sukanta0011/BabyMonitor/screenshots/babymonitor_v1.gif

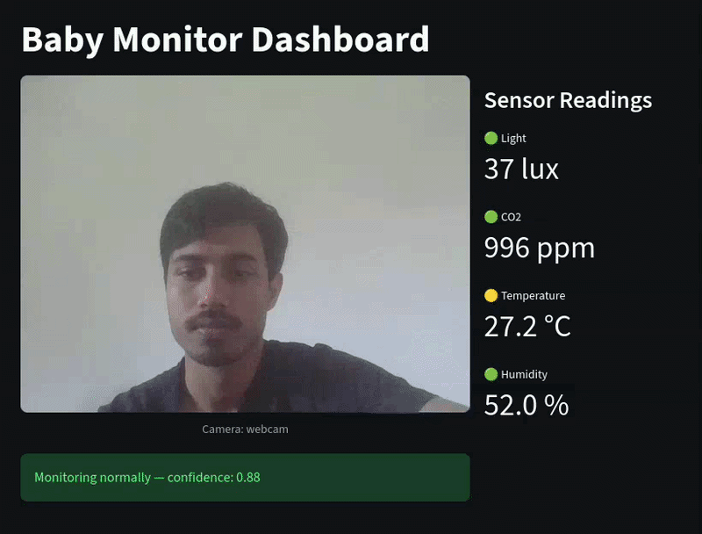
screenshots/babymonitor_v1.gif
