sukanta0011/BabyMonitor/esp32_codes/display/main/main.ino

#include <algorithm>
#include <HTTPClient.h>
#include <TJpg_Decoder.h>
#include <Arduino_GFX_Library.h>
#include <ArduinoJson.h>
#include "utils.hpp"
#include "ringBuffer.hpp"


// // Pin Definitions for ESP32-S3-CAM
// #define TFT_MOSI 17
// #define TFT_SCLK 18
// #define TFT_CS    3
// #define TFT_DC   15
// #define TFT_RST  16

// Pin Definitions for ESP32-S3-dev-kit
#define TFT_MOSI 11
#define TFT_SCLK 12
#define TFT_CS   10
#define TFT_DC   15
#define TFT_RST  16

// Interrupt Button
#define BUTTON_PIN 9

// Colour
#define COLOR_TEMP   0xFBE0  // orange
#define COLOR_HUM    0x07FF  // cyan
#define COLOR_CO2    0xF800  // red
#define COLOR_LUX    0xFFE0  // yellow
#define COLOR_BG     0x0000  // black
#define COLOR_LABEL  0x8410  // grey
#define COLOR_WHT    0xFFFF  // grey


const uint32_t                      buffer_size = 102400;
uint32_t                            start = 0, end = 0;
std::string                         marker = "--frame\r\n";
HTTPClient                          cam1Http, cam2Http, sensorHttp;
WiFiClient                          *cam1Stream, *cam2Stream;
// HTTPClient                          *activeHttp;
WiFiClient                          *stream;
int                                 httpCode;
RingBuffer<uint8_t, buffer_size>    buffer;
uint8_t                             *buffer_cpy = (uint8_t*)ps_malloc(buffer_size);
Arduino_DataBus                     *bus = new Arduino_ESP32SPI(
    TFT_DC, TFT_CS, TFT_SCLK, TFT_MOSI, GFX_NOT_DEFINED);
Arduino_GFX                         *gfx = new Arduino_ILI9488_18bit(
    bus, TFT_RST, 3 /* rotation */, false /* IPS */);
TaskHandle_t    readTaskHandle, extractAndDisplayTask, sensorTaskHandler;


float                               lux_val = 0, temp_val = 0, humidity_val = 0;
int                                 co2_val = 0;
bool                                sensors_valid = false;
SemaphoreHandle_t                   sensor_mutex;
volatile uint32_t                   last_interrupt_time = 0;
char outdoor_city[24] = "";
float outdoor_temp = 0, outdoor_humidity = 0;
bool outdoor_valid = false;

uint16_t src_img_w, src_img_h;
float scale_factor = 1.0;

enum     DisplayMode { SENSORS, CAM1, CAM2};
volatile DisplayMode requested_mode = CAM2;
volatile DisplayMode current_mode = CAM2;

struct  task_status 
{
    bool    read_task = false;
    bool    display_task = false;
    bool    sensor_task = false;
    bool    cam1_stream_status = false;
    bool    cam2_stream_status = false;
    bool    sensor_stream_status = false;
};


task_status taskStatus;

void    IRAM_ATTR button_isr()
{
    uint32_t    now = millis();
    if (now - last_interrupt_time > 50)
    {
        requested_mode = (DisplayMode)((requested_mode + 1) % 3);
        // Serial.print("ISR: ");
        // Serial.print(current_mode);
        // Serial.println(requested_mode);
        last_interrupt_time = now;
    }
}


void    read_from_stream(uint32_t max_read=buffer_size)
{
    uint32_t    bytes_read = 0;
    uint8_t     temp[512];
    // uint8_t     val;
    while (stream->available() && bytes_read < max_read)
    {
        size_t n = stream->readBytes(temp, min((size_t)stream->available(), sizeof(temp)));
        for (size_t i = 0; i < n; i++)
        {
            buffer.push(temp[i]);
            bytes_read += 1;
        }
    }
}


void    flush_old_stream(WiFiClient *old_stream)
{
    uint8_t     temp[512];
    while (old_stream->available())
    {
        size_t n = old_stream->readBytes(temp, min((size_t)stream->available(), sizeof(temp)));
    }
}


bool jpeg_output_callback(int16_t x, int16_t y, uint16_t w, uint16_t h, uint16_t* bitmap)
{
    static uint16_t scaled_block[32 * 32];

    int16_t dst_x = (int16_t)round(x * scale_factor);
    int16_t dst_x_end = (int16_t)round((x + w) * scale_factor);
    int16_t dst_w = dst_x_end - dst_x;

    int16_t dst_y = (int16_t)round(y * scale_factor);
    int16_t dst_y_end = (int16_t)round((y + h) * scale_factor);
    int16_t dst_h = dst_y_end - dst_y;

    if (dst_w <= 0 || dst_h <= 0) return true;  // block scales to nothing, skip
    uint32_t inv = (uint32_t)(65536.0f / scale_factor);

    for (int16_t j = 0; j < dst_h; j++)
    {
        // int16_t src_j = min((int16_t)(j / scale_factor), (int16_t)(h - 1));
        int16_t src_j = (j * inv) >> 16;
        for (int16_t i = 0; i < dst_w; i++)
        {
            // int16_t src_i = min((int16_t)(i / scale_factor), (int16_t)(w - 1));
            int16_t src_i = (i * inv) >> 16;
            scaled_block[j * dst_w + i] = bitmap[src_j * w + src_i];
        }
    }

    gfx->draw16bitRGBBitmap(dst_x, dst_y, scaled_block, dst_w, dst_h);
    return true;
}


void setup_decoder()
{
    TJpgDec.setJpgScale(1);  // decode at 1/2 scale
    TJpgDec.setCallback(jpeg_output_callback);
}


void decode_and_display(uint8_t *frame, uint32_t frame_size)
{
    if (frame_size >= buffer_size) return;

    if (TJpgDec.getJpgSize(&src_img_w, &src_img_h, frame, frame_size) != JDR_OK)
    {
        return;  // couldn't determine size, skip this frame
    }

    float ratio_w = (float)src_img_w / 480.0;
    float ratio_h = (float)src_img_h / 320.0;
    scale_factor = 1.0 / max(ratio_w, ratio_h);  // letterbox: fit entirely inside

    TJpgDec.drawJpg(0, 0, frame, frame_size);
}


// bool    extract_frame(
//     uint8_t *data, const uint32_t size, uint32_t &start, uint32_t &end)
// {
    
//     auto    it = std::search(data, data + size, marker.begin(), marker.end());
//     if (it == (data + size)) { return false;}
//     start = std::distance(data, it + marker.size());
//     auto    end_it = std::search(
//         it + marker.size(), data + size, marker.begin(), marker.end());
//     if (end_it == data + size) { return false; }
//     end = std::distance(data, end_it);
//     return true;
// }


bool extract_frame(
    uint8_t *data, const uint32_t size, uint32_t &start, uint32_t &end)
{
    using rev = std::reverse_iterator<uint8_t*>;
    rev rbegin(data + size), rend(data);

    // last marker in the buffer (searching from the end)
    auto last = std::search(rbegin, rend, marker.rbegin(), marker.rend());
    if (last == rend) { return false; }

    // marker before that one: continue searching past the last marker
    auto prev = std::search(last + marker.size(), rend,
                            marker.rbegin(), marker.rend());
    if (prev == rend) { return false; }

    // .base() points one past the element a reverse iterator refers to,
    // so subtract marker.size() to land on the marker's first byte
    uint8_t *last_marker_start = last.base() - marker.size();
    uint8_t *prev_marker_start = prev.base() - marker.size();

    start = (prev_marker_start + marker.size()) - data;
    end   = last_marker_start - data;
    return true;
}


void    draw_sensor_panel()
{
    // Serial.println("Sensor panle drawing...");
    int screen_w = 480;
    int screen_h = 320;
    int strip_h = 50;
    int grid_top = strip_h;
    int grid_h = screen_h - strip_h;
    int cell_w = screen_w / 2;
    int cell_h = grid_h / 2;

    gfx->fillScreen(COLOR_BG);

    xSemaphoreTake(sensor_mutex, portMAX_DELAY);
    float local_lux = lux_val, local_temp = temp_val, local_humidity = humidity_val;
    int local_co2 = co2_val;
    bool local_valid = sensors_valid;
    char local_city[24];
    strncpy(local_city, outdoor_city, sizeof(local_city));
    float local_out_temp = outdoor_temp, local_out_hum = outdoor_humidity;
    bool local_out_valid = outdoor_valid;
    xSemaphoreGive(sensor_mutex);

    if (!local_valid)
    {
        gfx->setTextColor(COLOR_LABEL);
        gfx->setTextSize(2);
        gfx->setCursor(30, screen_h / 2 - 10);
        gfx->println("Sensors: waiting...");
        return;
    }

    // outdoor strip
    gfx->fillRect(0, 0, screen_w, strip_h, COLOR_WHT);
    gfx->setTextColor(COLOR_BG);
    gfx->setTextSize(3);
    gfx->setCursor(10, 15);
    if (local_out_valid)
    {
        char outdoor_str[48];
        snprintf(outdoor_str, sizeof(outdoor_str), "%s  T: %.1fC  H: %.0f%%",
                 local_city, local_out_temp, local_out_hum);
        gfx->println(outdoor_str);
    }
    else
    {
        gfx->println("Outdoor: unavailable");
    }

    // indoor 2x2 grid, unchanged logic, shifted down by grid_top
    struct Cell {
        int row, col;
        uint16_t color;
        const char* label;
        char value[16];
    };

    char temp_str[16], hum_str[16], co2_str[16], lux_str[16];
    snprintf(temp_str, sizeof(temp_str), "%.1f C", local_temp);
    snprintf(hum_str, sizeof(hum_str), "%.1f %%", local_humidity);
    snprintf(co2_str, sizeof(co2_str), "%d ppm", local_co2);
    snprintf(lux_str, sizeof(lux_str), "%.1f lux", local_lux);

    Cell cells[4] = {
        {0, 0, COLOR_TEMP, "TEMP", ""},
        {0, 1, COLOR_HUM,  "HUMIDITY", ""},
        {1, 0, COLOR_CO2,  "CO2", ""},
        {1, 1, COLOR_LUX,  "LIGHT", ""},
    };
    strncpy(cells[0].value, temp_str, sizeof(cells[0].value));
    strncpy(cells[1].value, hum_str,  sizeof(cells[1].value));
    strncpy(cells[2].value, co2_str,  sizeof(cells[2].value));
    strncpy(cells[3].value, lux_str,  sizeof(cells[3].value));

    for (int i = 0; i < 4; i++)
    {
        int x = cells[i].col * cell_w;
        int y = grid_top + cells[i].row * cell_h;

        gfx->fillRect(x + 4, y + 4, cell_w - 8, cell_h - 8, cells[i].color);

        gfx->setTextColor(COLOR_BG);
        gfx->setTextSize(2);
        gfx->setCursor(x + 20, y + 25);
        gfx->println(cells[i].label);

        gfx->setTextSize(4);
        gfx->setCursor(x + 20, y + cell_h / 2);
        gfx->println(cells[i].value);
    }
    // Serial.println("Sensor panle drawing completed");
}


void    read_task(void *parameter)
{
    // Serial.print("read_task running on core: ");
    // Serial.println(xPortGetCoreID());
    while (true)
    {
        read_from_stream();
        vTaskDelay(pdMS_TO_TICKS(5));
    }
}


void    extract_and_display_task(void *parameter)
{
    // Serial.print("extract_and_display_task running on core: ");
    // Serial.println(xPortGetCoreID());

    setup_decoder();
    while (true)
    {
        buffer.copy_data(buffer_cpy);
        bool found = extract_frame(buffer_cpy, buffer_size, start, end);
        if (found)
        {
            decode_and_display(buffer_cpy + start, (end - start));
        }
        vTaskDelay(pdMS_TO_TICKS(5));
    }
}


void sensor_task(void *parameter)
{
    // Serial.print("sensor_task running on core: ");
    // Serial.println(xPortGetCoreID());

    // Serial.println("sensor_task function");
    while (true)
    {
        fetch_sensors();
        vTaskDelay(pdMS_TO_TICKS(10000));  // 10 second interval
    }
}


void show_splash_screen()
{
    gfx->fillScreen(COLOR_BG);
    gfx->setTextColor(0xFFFF);
    gfx->setTextSize(3);
    gfx->setCursor(60, 130);
    gfx->println("Baby Monitor");
    gfx->setTextSize(2);
    gfx->setTextColor(0xFFFF);
    gfx->setCursor(90, 170);
    gfx->println("Starting up...");
    delay(2000);
}


void    start_live_stream()
{
    if (!taskStatus.read_task)
    {
        xTaskCreate(read_task, "ReadTask", 8192, NULL, 1, &readTaskHandle);
        taskStatus.read_task = true;
    }
    else {vTaskResume(readTaskHandle);}
    if (!taskStatus.display_task)
    {
        xTaskCreate(
            extract_and_display_task, "ExtractAndDispay",
            8192, NULL, 1, &extractAndDisplayTask);
        taskStatus.display_task = true;
    }
    else { vTaskResume(extractAndDisplayTask); }
}


void    stop_live_stream()
{
    // http.end();
    if (taskStatus.display_task)
    { vTaskSuspend(extractAndDisplayTask); }
    if (taskStatus.read_task)
    { vTaskSuspend(readTaskHandle); }
}


void    fetch_sensors()
{
    // Serial.println("sensor task running...");
    // Serial.println("fetch_sensors func");
    sensorHttp.begin("http://pi5.local:8000/sensors");
    sensorHttp.setReuse(false);
    httpCode = sensorHttp.GET();
    // Serial.println(httpCode);

    if (httpCode == 200)
    {
        String                  payload = sensorHttp.getString();
        JsonDocument            doc;
        DeserializationError    err = deserializeJson(doc, payload);

        if (!err)
        {
            xSemaphoreTake(sensor_mutex, portMAX_DELAY);
            lux_val = doc["bh1750"]["lux"] | 0.0;
            co2_val = doc["scd40"]["co2"] | 0;
            temp_val = doc["scd40"]["temperature"] | 0.0;
            humidity_val = doc["scd40"]["humidity"] | 0.0;

            const char* city = doc["outdoor"]["city"] | "";
            strncpy(outdoor_city, city, sizeof(outdoor_city) - 1);
            outdoor_city[sizeof(outdoor_city) - 1] = '\0';
            outdoor_temp = doc["outdoor"]["temperature"] | 0.0;
            outdoor_humidity = doc["outdoor"]["humidity"] | 0.0;
            outdoor_valid = doc["outdoor"]["valid"] | false;

            sensors_valid = true;
            xSemaphoreGive(sensor_mutex);
            // Serial.print("co2_val: ");
            // Serial.println(co2_val);

            draw_sensor_panel();
        }
        else { Serial.println("JSON parse error...."); }
    }
    else
    {
        Serial.print("HTTP GET failed, code: ");
        Serial.println(httpCode);
    }
    // vTaskDelay(pdMS_TO_TICKS(1000));
    sensorHttp.end();
}


void show_error_message(const char* message)
{
    gfx->fillScreen(COLOR_BG);
    gfx->setTextColor(0xF800);  // red
    gfx->setTextSize(2);
    gfx->setCursor(20, 150);
    gfx->println(message);
}

void    start_sensor_stream()
{
    if (!taskStatus.sensor_task)
    {
        xTaskCreate(sensor_task, "SensorTask", 8192, NULL, 0, &sensorTaskHandler);
        taskStatus.sensor_task = true;
    }
    else { vTaskResume(sensorTaskHandler); }
}


void    stop_sensor_stream()
{
    vTaskSuspend(sensorTaskHandler);
}

void    flush_buffer_cpy()
{
    for (uint32_t i=0; i<=buffer_size; i++)
    {
        buffer_cpy[i] = 0;
    }
}

void stop_everything()
{
    if (taskStatus.display_task) vTaskSuspend(extractAndDisplayTask);
    if (taskStatus.read_task)    vTaskSuspend(readTaskHandle);
    if (taskStatus.sensor_task)  vTaskSuspend(sensorTaskHandler);
    cam1Http.end();
    cam2Http.end();
    taskStatus.cam1_stream_status = false;
    taskStatus.cam2_stream_status = false;
    taskStatus.sensor_stream_status = false;
}

void    switch_to_mode(DisplayMode mode) {
    gfx->fillScreen(0);
    stop_everything();
    current_mode = mode;

    if (mode == SENSORS) {
        // Serial.println("SENSORS starting...");
        start_sensor_stream();
        current_mode = mode;
        taskStatus.sensor_stream_status = true;
        // Serial.println("SENSORS started");
        // if (taskStatus.cam2_stream_status)
        // { 
        //     stop_live_stream();
        //     // flush_old_stream(cam2Stream);
        //     cam2Http.end();
        //     taskStatus.cam2_stream_status = false;
        // }
        // else if (taskStatus.cam1_stream_status)
        // { 
        //     stop_live_stream();
        //     cam1Http.end();
        //     taskStatus.cam1_stream_status = false;
        // }
        // return;
    }
    if (mode == CAM1)
    {
        Serial.println("CAM1 starting...");
        cam1Http.begin("http://pi5.local:8000/video/cam1");
        cam1Http.setReuse(false);

        httpCode = cam1Http.GET();
        if (httpCode == 200) {
            cam1Stream = cam1Http.getStreamPtr();
            stream = cam1Stream;
            buffer.reset();
            flush_buffer_cpy();
            start_live_stream();
            current_mode = mode;
            taskStatus.cam1_stream_status = true;
            // if (taskStatus.sensor_stream_status) { 
            //     stop_sensor_stream(); 
            //     taskStatus.sensor_stream_status = false;
            // }
            // if (taskStatus.cam2_stream_status)
            // { 
            //     // flush_old_stream(cam2Stream);
            //     cam2Http.end(); 
            // }
            Serial.println("CAM1 started");
        } else {
            Serial.print("Unable to connect to Pi5. HTTP Code: ");
            Serial.println(httpCode);
            cam1Http.end();
            taskStatus.cam1_stream_status = false;
            show_error_message("Camera unavailable");
        }
        
        // return;
    }
    if (mode == CAM2)
    {
        Serial.println("CAM2 starting...");
        // if (taskStatus.sensor_stream_status) { stop_sensor_stream(); }
        cam2Http.begin("http://pi5.local:8000/video/cam2");
        cam2Http.setReuse(false);
        httpCode = cam2Http.GET();
        if (httpCode == 200) {
            cam2Stream = cam2Http.getStreamPtr();
            stream = cam2Stream;
            buffer.reset();
            flush_buffer_cpy();
            start_live_stream();
            current_mode = mode;
            taskStatus.cam2_stream_status = true;
            // if (taskStatus.sensor_stream_status) { 
            //     stop_sensor_stream(); 
            //     taskStatus.sensor_stream_status = false;
            // }
            // if (taskStatus.cam1_stream_status)
            // { 
            //     // flush_old_stream(cam1Stream);
            //     cam1Http.end(); 
            // }
            Serial.println("CAM2 started");
        }
        else {
            Serial.print("Unable to connect to Pi5. HTTP Code: ");
            Serial.println(httpCode);
            
            cam2Http.end();
            taskStatus.cam2_stream_status = false;
            show_error_message("Camera unavailable");
        }
        
        // return;
    }
}


void    setup()
{
    Serial.begin(115200);
    // start_sensor_stream();
    // start_live_stream();
    pinMode(BUTTON_PIN, INPUT);
    attachInterrupt(digitalPinToInterrupt(BUTTON_PIN), button_isr, FALLING);
    if (!connect_to_wifi()) { return; }
    if (!gfx->begin()) { Serial.println("gfx->begin() failed!"); }
    else {
        gfx->fillScreen(0);
        show_splash_screen();
    }
    sensor_mutex = xSemaphoreCreateMutex();
    switch_to_mode(requested_mode);
}


void    loop()
{
    if (current_mode != requested_mode)
    {
        switch_to_mode(requested_mode);
        // Serial.println(requested_mode);
    }
    delay(10);
}
