sukanta0011/BabyMonitor/esp32_codes/custom_camera_server/custom_camera_server.ino

#include "esp_camera.h"
#include "esp_http_server.h"
#include <WiFi.h>
#include "search.h"

// --- AI-Thinker Pin Mapping ---
#define PWDN_GPIO_NUM   32
#define RESET_GPIO_NUM  -1
#define XCLK_GPIO_NUM    0
#define SIOD_GPIO_NUM   26
#define SIOC_GPIO_NUM   27
#define Y9_GPIO_NUM     35
#define Y8_GPIO_NUM     34
#define Y7_GPIO_NUM     39
#define Y6_GPIO_NUM     36
#define Y5_GPIO_NUM     21
#define Y4_GPIO_NUM     19
#define Y3_GPIO_NUM     18
#define Y2_GPIO_NUM      5
#define VSYNC_GPIO_NUM  25
#define HREF_GPIO_NUM   23
#define PCLK_GPIO_NUM   22
#define LED_GPIO_NUM     4

// --- Official Espressif Multipart Framing ---
#define PART_BOUNDARY "123456789000000000000987654321"
static const char *_STREAM_CONTENT_TYPE = "multipart/x-mixed-replace;boundary=" PART_BOUNDARY;
static const char *_STREAM_BOUNDARY = "\r\n--" PART_BOUNDARY "\r\n";
static const char *_STREAM_PART = "Content-Type: image/jpeg\r\nContent-Length: %u\r\n\r\n";

static httpd_handle_t stream_httpd = NULL;

static esp_err_t stream_handler(httpd_req_t *req)
{
    camera_fb_t *fb = NULL;
    esp_err_t res = ESP_OK;
    char part_buf[128];

    // Set initial response headers
    res = httpd_resp_set_type(req, _STREAM_CONTENT_TYPE);
    if (res != ESP_OK) {
        return res;
    }
    httpd_resp_set_hdr(req, "Access-Control-Allow-Origin", "*");

    // Target ~15 FPS: 1000ms / 15 ≈ 66ms period
    TickType_t last_wake_time = xTaskGetTickCount();
    const TickType_t frame_interval = pdMS_TO_TICKS(66);

    while (true)
    {
        fb = esp_camera_fb_get();
        if (!fb) {
            Serial.println("Camera capture failed");
            res = ESP_FAIL;
            break;
        }

        // 1. Send boundary token
        res = httpd_resp_send_chunk(req, _STREAM_BOUNDARY, strlen(_STREAM_BOUNDARY));

        // 2. Send per-frame header
        if (res == ESP_OK) {
            size_t hlen = snprintf(part_buf, sizeof(part_buf), _STREAM_PART, (uint32_t)fb->len);
            res = httpd_resp_send_chunk(req, part_buf, hlen);
        }

        // 3. Send raw JPEG payload
        if (res == ESP_OK) {
            res = httpd_resp_send_chunk(req, (const char *)fb->buf, fb->len);
        }

        // Always release buffer immediately back to DMA pool
        esp_camera_fb_return(fb);
        fb = NULL;

        // If client closed connection, break loop
        if (res != ESP_OK) {
            break;
        }

        // Smooth rate-limiting: sleeps only for remaining time in current 66ms slot
        vTaskDelayUntil(&last_wake_time, frame_interval);
    }

    return res;
}

static bool start_stream_server()
{
    httpd_config_t config = HTTPD_DEFAULT_CONFIG();
    config.server_port = 80;
    config.ctrl_port = 32768;
    config.max_open_sockets = 2; // Keep small to conserve memory

    httpd_uri_t stream_uri = {
        .uri       = "/stream",
        .method    = HTTP_GET,
        .handler   = stream_handler,
        .user_ctx  = NULL
    };

    if (httpd_start(&stream_httpd, &config) == ESP_OK) {
        httpd_register_uri_handler(stream_httpd, &stream_uri);
        return true;
    }
    return false;
}

static esp_err_t init_camera()
{
    camera_config_t config;
    config.ledc_channel = LEDC_CHANNEL_0;
    config.ledc_timer = LEDC_TIMER_0;
    config.pin_d0 = Y2_GPIO_NUM;
    config.pin_d1 = Y3_GPIO_NUM;
    config.pin_d2 = Y4_GPIO_NUM;
    config.pin_d3 = Y5_GPIO_NUM;
    config.pin_d4 = Y6_GPIO_NUM;
    config.pin_d5 = Y7_GPIO_NUM;
    config.pin_d6 = Y8_GPIO_NUM;
    config.pin_d7 = Y9_GPIO_NUM;
    config.pin_xclk = XCLK_GPIO_NUM;
    config.pin_pclk = PCLK_GPIO_NUM;
    config.pin_vsync = VSYNC_GPIO_NUM;
    config.pin_href = HREF_GPIO_NUM;
    config.pin_sccb_sda = SIOD_GPIO_NUM;
    config.pin_sccb_scl = SIOC_GPIO_NUM;
    config.pin_pwdn = PWDN_GPIO_NUM;
    config.pin_reset = RESET_GPIO_NUM;
    config.xclk_freq_hz = 20000000;
    config.pixel_format = PIXFORMAT_JPEG;
    config.frame_size = FRAMESIZE_VGA;
    config.jpeg_quality = 13; // Lower = sharper (10-15 recommended)
    config.fb_count = 1;
    config.grab_mode = CAMERA_GRAB_WHEN_EMPTY;
    config.fb_location = CAMERA_FB_IN_PSRAM;

    esp_err_t err = esp_camera_init(&config);
    if (err != ESP_OK) {
        return err;
    }

    // Tune sensor DSP for clearer output
    sensor_t *s = esp_camera_sensor_get();
    if (s != NULL) {
        s->set_contrast(s, 1);
        s->set_brightness(s, 0);
        s->set_saturation(s, 0);
        s->set_whitebal(s, 1);
        s->set_awb_gain(s, 1);
        s->set_exposure_ctrl(s, 1);
        s->set_gain_ctrl(s, 1);
        s->set_bpc(s, 1);
        s->set_wpc(s, 1);
        s->set_lenc(s, 1);
    }

    return ESP_OK;
}

static bool connect_wifi(const char *ssid, const char *password)
{
    WiFi.begin(ssid, password);
    int retries = 20;
    while (WiFi.status() != WL_CONNECTED && retries > 0) {
        delay(500);
        retries--;
    }
    return (WiFi.status() == WL_CONNECTED);
}

void setup()
{
    Serial.begin(115200);

    // Disable flash LED transistor float
    pinMode(LED_GPIO_NUM, OUTPUT);
    digitalWrite(LED_GPIO_NUM, LOW);

    // Initialize camera driver
    if (init_camera() != ESP_OK) {
        Serial.println("Camera init failed!");
        return;
    }

    // Connect Wi-Fi

    if (!connect_wifi(WIFI_SSID, WIFI_PASSWORD)) {
        Serial.println("Wi-Fi connection failed!");
        return;
    }

    // Keep Wi-Fi radio fully active (low latency, high throughput)
    WiFi.setSleep(false);

    // Start streaming server
    if (start_stream_server()) {
        Serial.print("Stream active: http://");
        Serial.print(WiFi.localIP());
        Serial.println("/stream");
    } else {
        Serial.println("HTTP server failed to start");
    }
}

void loop()
{
    // The HTTP server task runs independently on Core 0/1; loop can stay idle
    vTaskDelay(pdMS_TO_TICKS(1000));
}
