sukanta0011/BabyMonitor/esp32_codes/rtsp_stream/rtsp_stream.ino

#include "esp_camera.h"
#include <WiFi.h>
#include <OV2640Streamer.h>
#include <OV2640.h>
#include <CRtspSession.h>

OV2640 cam;
CStreamer *streamer = NULL;
CRtspSession *session = NULL;
WiFiClient rtspClient;

// // --- Wi-Fi Settings ---
const char* ssid = "TP-Link_509A";
const char* password = "******";


// --- AI-Thinker Hardware Pin Mapping ---
#define PWDN_GPIO_NUM     32
#define RESET_GPIO_NUM    -1
#define XCLK_GPIO_NUM      0
#define SIOD_GPIO_NUM     26
#define SIOC_GPIO_NUM     27
#define Y9_GPIO_NUM       35
#define Y8_GPIO_NUM       34
#define Y7_GPIO_NUM       39
#define Y6_GPIO_NUM       36
#define Y5_GPIO_NUM       21
#define Y4_GPIO_NUM       19
#define Y3_GPIO_NUM       18
#define Y2_GPIO_NUM        5
#define VSYNC_GPIO_NUM    25
#define HREF_GPIO_NUM     23
#define PCLK_GPIO_NUM     22

// Network Server and Streamer Pointers
WiFiServer rtspServer(554); 
// CStreamer *streamer = NULL;
// WiFiClient rtspClient;

void setup() {
  Serial.begin(115200);
  delay(1000); // Give the serial hardware monitor time to catch up
  Serial.println("Booting System...");
  
  // 1. Camera Hardware Configuration
  camera_config_t config;
  config.ledc_channel = LEDC_CHANNEL_0;
  config.ledc_timer = LEDC_TIMER_0;
  config.pin_d0 = Y2_GPIO_NUM;
  config.pin_d1 = Y3_GPIO_NUM;
  config.pin_d2 = Y4_GPIO_NUM;
  config.pin_d3 = Y5_GPIO_NUM;
  config.pin_d4 = Y6_GPIO_NUM;
  config.pin_d5 = Y7_GPIO_NUM;
  config.pin_d6 = Y8_GPIO_NUM;
  config.pin_d7 = Y9_GPIO_NUM;
  config.pin_xclk = XCLK_GPIO_NUM;
  config.pin_pclk = PCLK_GPIO_NUM;
  config.pin_vsync = VSYNC_GPIO_NUM;
  config.pin_href = HREF_GPIO_NUM;
  config.pin_sscb_sda = SIOD_GPIO_NUM;
  config.pin_sscb_scl = SIOC_GPIO_NUM;
  config.pin_pwdn = PWDN_GPIO_NUM;
  config.pin_reset = RESET_GPIO_NUM;
  config.xclk_freq_hz = 20000000;
  config.pixel_format = PIXFORMAT_JPEG;

  // Frame settings optimized for network performance (VGA @ High Compression)
  config.frame_size = FRAMESIZE_VGA;
  config.jpeg_quality = 12; // 0-63 (lower means higher quality, 12 is a sweet spot)
  config.fb_count = 1;      // Dual buffer prevents frame tearing

  // Initialize the camera hardware wrapper
  Serial.println("Initializing Camera HAL...");
  esp_err_t err = cam.init(config);
  if (err != ESP_OK) {
    Serial.printf("Camera init failed with error 0x%x", err);
    return;
  }
  Serial.println("Camera HAL Up!");

  // Start the network layer
  Serial.printf("Attempting Wi-Fi Connection to: %s\n", ssid);
  WiFi.begin(ssid, password);
  while (WiFi.status() != WL_CONNECTED) {
    delay(500);
    Serial.print(".");
  }
  Serial.println("\nWi-Fi Connected!");

  rtspServer.begin();
  
  // Pass the camera object pointer to the streamer
  streamer = new OV2640Streamer(&cam); 
  
  Serial.print("RTSP URL: rtsp://");
  Serial.print(WiFi.localIP());
  Serial.println(":554/mjpeg/1");
}

void loop() {
  uint32_t msecPerFrame = 100; // 10 FPS target
  static uint32_t lastFrameTime = 0;

  // Check for incoming client connections
  if (!rtspClient.connected()) {
    rtspClient = rtspServer.available();
    if (rtspClient.connected()) {
      // Create a session when a client connects
      if (session) delete session;
      session = new CRtspSession(&rtspClient, streamer);
    }
    return;
  }

  // Active session execution loop
  if (millis() - lastFrameTime > msecPerFrame) {
    if (session) {
      session->handleRequests(0); // Let the session process packets
    }
    lastFrameTime = millis();
  }
}
