sukanta0011/BabyMonitor/(commit log)

2026-06-30 add threading tohandle each stream in seperate thread
    [partitions.csv]
2026-07-02 setup the server on esp32 for sending sensor data
2026-07-03 add SCD40 and BM1750 sensor data collection tested
2026-07-05 update the firmware to read data from sensor SCD40 and BM1750
2026-07-09 magicpipe testin is done on wbcam, and ready to implement for multiple cameras
2026-07-20 add: implement camera stream manager
2026-07-22 Remove firewall update commands section
    Removed firewall update commands for Camera 1 from README.
2026-07-22 Obscure WiFi password in CameraWebServer.ino
    Obscure the WiFi password for security purposes.
2026-07-23 stream manager is running on a different thread now
2026-08-02 fix the camrea strem to handle multiple use by replacing encoding to best frame base insted of per user base and change generator to async to reduce unnecessay blocking by sleep
    [custom_webserver.ino]
2026-08-04 add first temperature classifier test
2026-08-05 fix no camera detection error
2026-08-08 fix change the sensor stream for name to ip to avaoid the name resolving issue in docker side, later work on it again"
2026-08-11 add alert to print the alert when value is above threshold
2026-08-16 add camera auto discovery and failure detection
2026-08-16 add camera live state on frontend
2026-08-16 add sensor auto discovery in the stream as well
2026-08-16 add YuNet face detector from CV2 to avoid depedency conflict of mediapipe on Pi device
2026-08-17 add rounded numbers in frontend for sensor readings
2026-08-18 add manual camera selection option while best camera feed running on the background
2026-08-30 fix: resolve mypy, ruff findings, fix guard against None frame in detection loop, add lint/typecheck CI workflow
2026-09-01 Add: update the custom webserver to work on esp8266 board
2026-09-03 add the second camera and change the ip of the sensor stream to esp8266 ip
2026-09-03 fix: add camera to the global camera variable
2026-09-06 add: first working version of SPI display with ringbuffer implemented
2026-09-08 fix: fixed the sensor auto detection error by handlingthe http connection error properly
    [main.ino]
2026-09-09 move buffer DRAM to PSRAM of the esp32-s3-cam"
2026-09-16 add: scrren to the esp8266and showing the sensor reading withthe currrent location and the outside weather, implemented the switching thefeed between cameras and sensors by interrupt switch
    [partitions.csv]
2026-09-20 fix the switching error of using interrupt, now move each http client as seperate unit and send connection end signl after switching to new connetion
    [CameraWebServer.ino, main.ino, ringBuffer.hpp]
2026-09-20 docs: document ESP32-S3 display client, ESP8266 local weather display, Pi status dashboard
2026-09-20 add: option to zoom the video frame in the frontend
2026-09-28 add the intensity endpoint in the cameraserver on esp32-cam
2026-10-04 add BME280 sensor for temperature and humidity measuring
2026-10-04 update readme,remove logs and test frames'
